bmeisels/hackeriot_board/README.md

# Hackeriot Board #

Hackeriot Board is a research target for learning about Hardware Reverse Engineering.
The board was used as part of the Hardware Reverse Engineering workshop at the Hackeriot 2024 conference.

## What is in this repository?

* Hardware files for the Hackeriot Board
* Firmware for the MCU on the board
