bmeisels/hackeriot_board/(commit log)

2024-08-21 Schematic and basic layout complete
    [hackeriot_board.kicad_pcb, hackeriot_board.kicad_sch]
2024-08-21 Finished initial routing
    [hackeriot_board.kicad_pcb]
2024-08-22 Add control buttons
    [hackeriot_board.kicad_pcb, hackeriot_board.kicad_sch]
2024-08-22 Fixed connectors
    [hackeriot_board.kicad_pcb, hackeriot_board.kicad_sch]
2024-08-22 Add JLC placeholder
    [hackeriot_board.kicad_pcb]
2024-08-22 Add copper fill
    [hackeriot_board.kicad_pcb]
2024-08-22 Change to 4K eeprom that is in stock
    [hackeriot_board.kicad_pcb, hackeriot_board.kicad_sch]
2024-08-24 Fixed review comments
    [hackeriot_board.kicad_pcb, hackeriot_board.kicad_sch]
2024-08-25 Fix additional issues
    [hackeriot_board.kicad_pcb, hackeriot_board.kicad_sch]
2024-09-10 Major rework
    - Switched to AT24C library that can handle AT24C04 addressing mode;
    - Fixed pin definition
    - Implemented pixels boot sequence
    - Implemented rough EEPROM data format
    - Implemented alt mode (reset with any button pressed) that resets
    EEPROM contents
    - Implemented prev/next behaviour.
    [hackeriot_board_2024_firmware.ino]
2024-09-11 Bugfixes and palette change
    - Fixed buttons bug (Next and Prev were reversed, perhaps due to the
    PA_0 -> PA0 change)
    - Fixed wrong endianity in eeprom_read_color (BGR -> RGB)
    - Changed eeprom palette (use alt_mode to reprogram current eeprom)
    [hackeriot_board_2024_firmware.ino]
2024-10-07 Change GND header to dual socket
    [hackeriot_board.kicad_pcb, hackeriot_board.kicad_sch]
2024-10-07 Add revision and Title
    [hackeriot_board.kicad_sch]
2024-10-07 Change resistors for power LEDs
    [hackeriot_board.kicad_sch]
2024-10-07 Fix JLC order number placeholder
    [hackeriot_board.kicad_pcb]
2025-08-03 Add 2025 hardware schematic
    [hackeriot_board_2025.kicad_pcb, hackeriot_board_2025.kicad_sch, led_matrix.kicad_sch]
2025-08-03 Add MPN for all components
    [hackeriot_board_2025.kicad_sch]
2025-08-03 Add missing footprint and update MPN
    [hackeriot_board_2025.kicad_sch]
2025-08-03 Fix symbols and footprints
    [hackeriot_board_2025.kicad_sch]
2025-08-06 Add reference to project footprint library
2025-08-06 Update schematic and symbol library
    [hackeriot_board_2025.kicad_sch]
2025-08-06 Initial layout
    [hackeriot_board_2025.kicad_pcb]
2025-08-13 Update layout and component ids
    [hackeriot_board_2025.kicad_pcb, hackeriot_board_2025.kicad_sch]
2025-08-14 Move USB connector to top
    [hackeriot_board_2025.kicad_pcb]
2025-08-14 anotate mounting holes and graphics
    [hackeriot_board_2025.kicad_pcb]
2025-08-16 Adjust config and DT
    GPIOs match mockup board, not real board.
2025-08-16 Add snake and kc
    Recheck LED orientation for real board.
2025-08-17 Add logo and icons
    [hackeriot_board_2025.kicad_pcb]
2025-08-17 Added Silk
    [hackeriot_board_2025.kicad_pcb]
2025-08-17 Routing complete
    [hackeriot_board_2025.kicad_pcb]
2025-08-17 Reworked LED breath using a thread
    [main.c]
2025-08-17 snake fix target acquiring bug
    [snake.c]
2025-08-18 Add fiducials
    [hackeriot_board_2025.kicad_pcb]
2025-08-18 Add serial number box
    [hackeriot_board_2025.kicad_pcb]
2025-08-18 Swap to tooling holes
    [hackeriot_board_2025.kicad_pcb]
2025-08-18 Fix rotations
    [hackeriot_board_2025.kicad_pcb, hackeriot_board_2025.kicad_sch]
2025-08-19 disable LED breath thread
2025-08-24 Refactor led code to seperate file
2025-09-01 Update board definitions
2025-09-02 Introduce led_glyph() utility function
    Returns a glyph given a character.
2025-09-02 Move LED breath stuff from main.c to kc.c
2025-09-02 Introduce do_menu(), no implementation yet
    Current implementation simply returns 0 (=snake).
2025-09-02 Fix GPIO assignment for board2025 (non-BB)
2025-09-02 Fix typo in led_glyph()
2025-09-02 Support rotated screen of board2025
    Moved POS_TO_LED to led.h and made it dependent on #define BREADBOARD
2025-09-06 Buttons rework
    Moved non-KC button processing to `buttons.c``; events are now stored
    internally in a `k_pipe` object.
    Other parts of the code can retrieve button press/release events via
    buttons_get(), with or without a timeout, with or without a filter.
    Adapted snake to use the new system; now it is possible to plan a snake
    path in advance.
    [buttons.c, buttons.h, main.c, simon.c, snake.c, snake.h]
2025-09-06 updated `led_glyph` to support all printable ASCII
2025-09-06 Slow down boot animation a bit back
    Also make it possible to skip it via button press.
2025-09-06 added buttons_clear() and optimized buttons_get()
2025-09-06 Implemented returning to main menu from games
    Currently play_snake() never returns, need to fix.
    [main.c]
2025-09-06 Introduced show_score() and reworked snake game
    Moved score displaying functionality from simon.c to main.c; all games
    now return a value (=score), which is displayed by main loop. It also
    handles restart game/back to menu functionality.
    Once EEPROM is supported, we could save high scores there.
    Snake game was reworked to fit the above template; in particular, some
    functionality was removed (A for pause, B to change speed, blink on
    crash, ability to restart game). Added crash animation.
    [main.c, simon.c, simon.h, snake.c, snake.h]
2025-09-06 Hebrew translation
    Added translation in `boot_animation`, `do_menu`, `show_score`, and
    `play_simon`. Pressing B in menu now switches language.
    Note that since the default is Hebrew, English boot animation currently
    cannot be displayed; need to store language in EEPROM.
2025-09-06 added missing `#include <zephyr/drivers/led.h>`
    [led.h]
2025-09-07 Screen major rework, language system minor rework
    Introduced `screen.[ch]` and removed `led.c` (but not `led.h`).
    `boot_animation` moved to `main.c` and LED breath function to `kc.c`.
    `screen_scroll_xxx` functions provide text scrolling common to all code.
    `screen_xxx_blink` functions allow per-pixel blink in one of two speeds
    (fast and slow speed, also per-pixel).
    Dropped breadboard screen support (which was very partial anyway).
    Language system is now easier to work with, and support for a third (or
    more) language is easy to add.
    [kc.c, led.h, main.c, screen.c, screen.h, simon.c, simon.h, snake.c]
2025-09-08 Move 2024 files and rename as necessary
    [hackeriot_board_2024.kicad_pcb, hackeriot_board_2024.kicad_sch]
2025-09-08 Colapse 2025 hardware
    [hackeriot_board_2025.kicad_pcb, hackeriot_board_2025.kicad_sch, led_matrix.kicad_sch]
2025-09-09 Some `main.c` rework; dropped maze game
    [main.c]
2025-09-09 Implemented persistence
    EEPROM now saves language, LED brightness, and scroll speed.
    New menu option allows to set these.
    Main thread stack size increase to avoid crashes.
    [main.c, persist.c, persist.h, screen.c, screen.h, simon.c, snake.c]
